smay4finger/WiFiModem/README.md

# WiFiModem
A nice looking Hayes compatible modem fully supporting RS232 on the basis of an ESP8266.

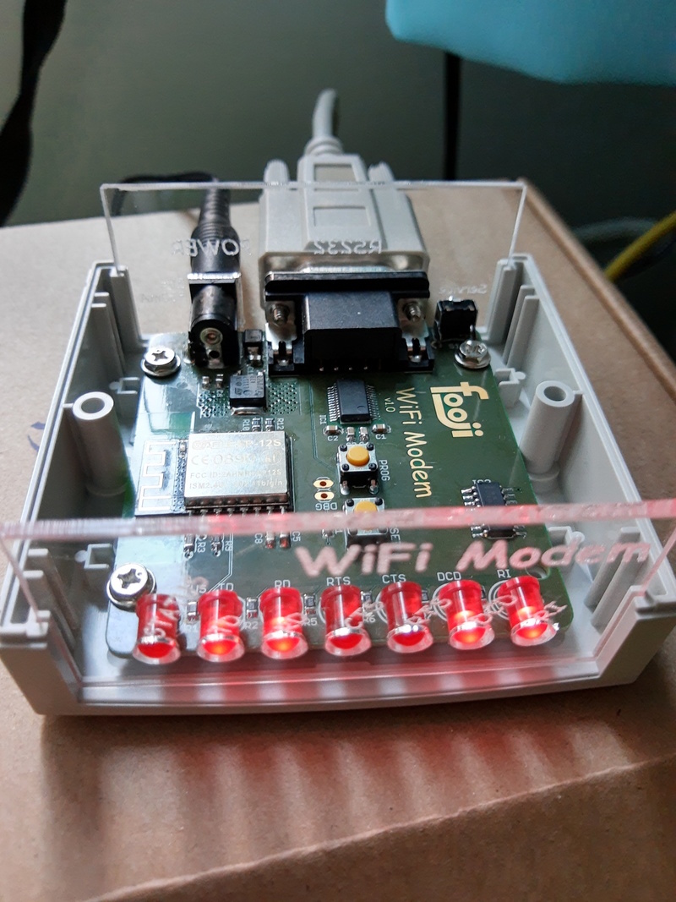
[picture p1: doc/hardware-v1.0.jpg]
Photo of hardware v1.0
