smay4finger/WiFiModem/enclosure/backpanel.dxf

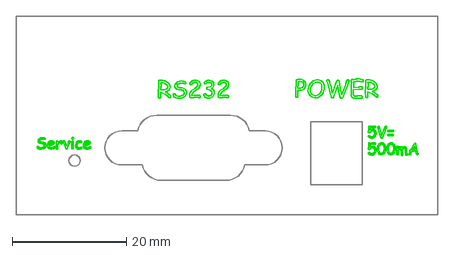
[picture p2: CAD file, 2020-03-23]
enclosure/backpanel.dxf
73.7 x 34.7 mm
