smay4finger/WiFiModem/enclosure/models/bopla-u85-top.stl

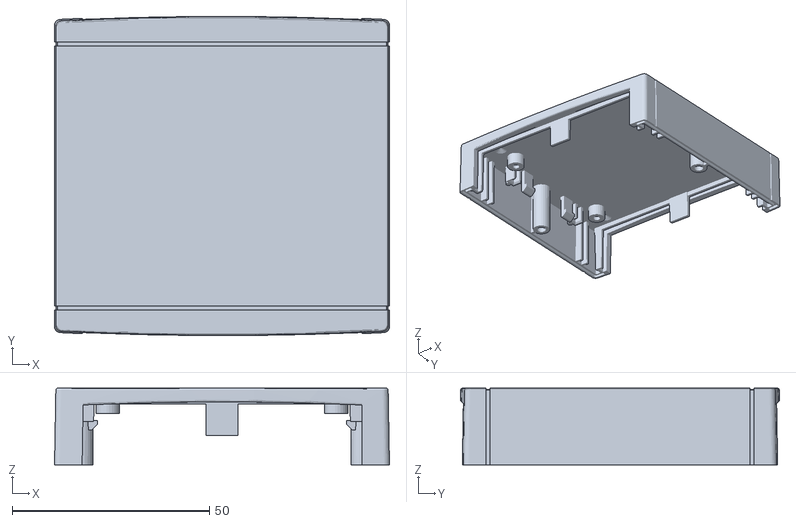
[picture p3: CAD file, 2020-03-23]
enclosure/models/bopla-u85-top.stl
85.0 x 81.0 x 19.5
