smay4finger/WiFiModem/enclosure/frontpanel.dxf

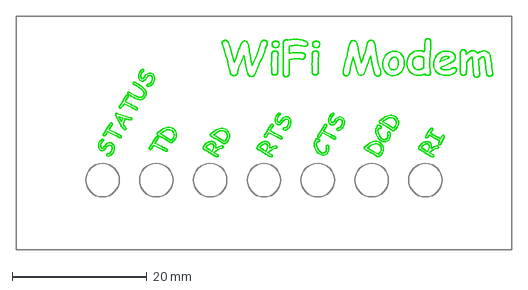
[picture p4: CAD file, 2020-03-23]
enclosure/frontpanel.dxf
73.7 x 34.7 mm
