smay4finger/WiFiModem/enclosure/models/bopla-u85-bot.stl

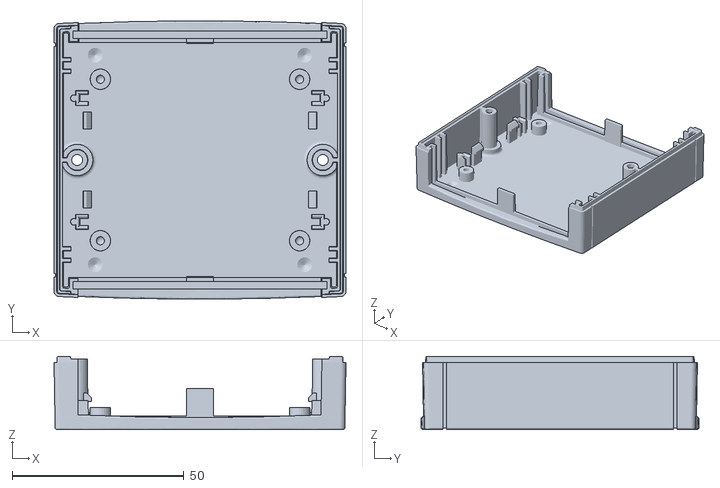
[picture p5: CAD file, 2020-03-23]
enclosure/models/bopla-u85-bot.stl
85.0 x 81.0 x 21.3
