smay4finger/WiFiModem/(threads)

Thread 2 (2021-01-21):

LEDs need to be inverted

smay4finger, 2021-01-21:
LEDs are on when idle on RS232. Would be better to invert, so CTS LED on means actually Clear To Send. A condensator parallel to the LED will help to improve visibility.
