smay4finger/WiFiModem/hardware/modem.brd

## EAGLE design hardware/modem.brd (2020-03-23)

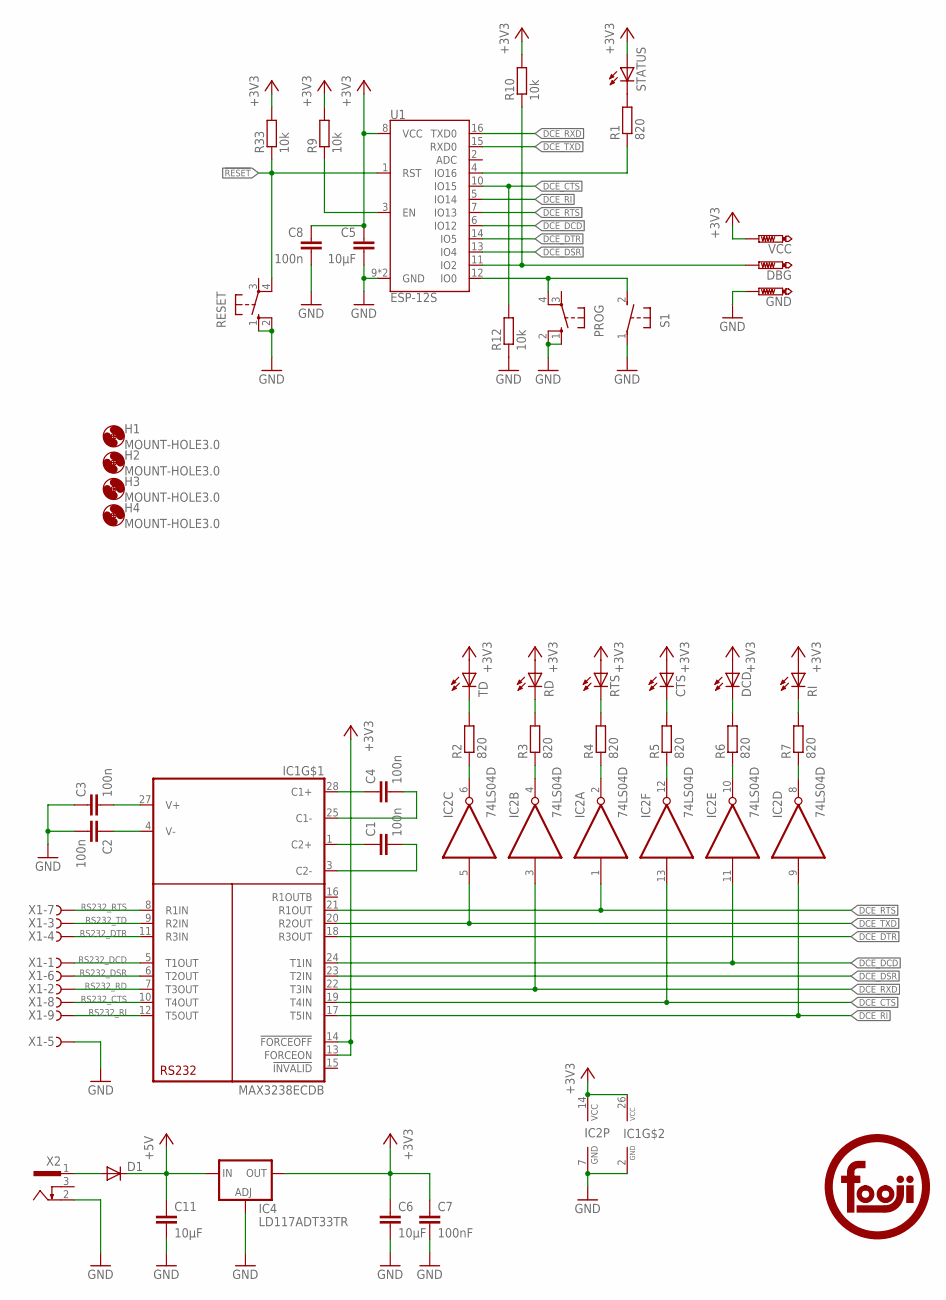
[picture p6: schematic modem.sch]

Parts:
C1, C2, C3, C4, C8: 100n; C0805
C5, C6, C11: 10µF; C0805
C7: 100nF; C0805
CTS: LED5MM
D1: DIODE-SMB; SMB
DBG: PTR1PAD1-13; P1-13
DCD: LED5MM
GND: PTR1PAD1-13; P1-13
H1, H2, H3, H4: MOUNT-HOLE3.0; 3,0
IC1: MAX3238ECDB; SSOP28
IC2: 74LS04D; SO14
IC4: LD117ADT33TR; DPACK
PROG: 10-XX; B3F-10XX
R1, R2, R3, R4, R5, R6, R7: 820; R0805
R9, R10, R12, R33: 10k; R0805
RD: LED5MM
RESET: 10-XX; B3F-10XX
RI: LED5MM
RTS: LED5MM
S1: 31-XX; B3F-31XX
STATUS: LED5MM
TD: LED5MM
U1: ESP-12S
U$3: LOGOTOP_NOCIRCLE_TSTOP; LOGO_TOP_NOCIRCLE_TSTOP
VCC: PTR1PAD1-13; P1-13
X1: F09HPS; F09HP
X2: 733980-62

Connections:
!RESET: R33.1, RESET.4 (P1), U1.1 (RST)
+3V3: C5.1, C6.1, C7.1, C8.1, CTS.A, DCD.A, IC1.13 (FORCEON), IC1.14 (!FORCEOFF), IC1.26 (VCC), IC2.14 (VCC), IC4.4 (OUT), R9.2, R10.2, R33.2, RD.A, RI.A, RTS.A, STATUS.A, TD.A, U1.8 (VCC), VCC.TP
+5V: C11.1, D1.C, IC4.3 (IN)
DCE_CTS: IC1.19 (T4IN), IC2.13 (I), R12.2, U1.10 (IO15)
DCE_DCD: IC1.24 (T1IN), IC2.11 (I), U1.6 (IO12)
DCE_DSR: IC1.23 (T2IN), U1.13 (IO4)
DCE_DTR: IC1.18 (R3OUT), U1.14 (IO5)
DCE_RI: IC1.17 (T5IN), IC2.9 (I), U1.5 (IO14)
DCE_RTS: IC1.21 (R1OUT), IC2.1 (I), U1.7 (IO13)
DCE_RXD: IC1.22 (T3IN), IC2.3 (I), U1.16 (TXD0)
DCE_TXD: IC1.20 (R2OUT), IC2.5 (I), U1.15 (RXD0)
DEBUG: DBG.TP, R10.1, U1.11 (IO2)
GND: C2.2, C3.1, C5.2, C6.2, C7.2, C8.2, C11.2, GND.TP, IC1.2 (GND), IC2.7 (GND), IC4.1 (ADJ), PROG.1 (S), PROG.2 (S1), R12.1, RESET.1 (S), RESET.2 (S1), S1.1, U1.9 (GND), U1.P$1 (GND), X1.5 (F), X2.2
unnamed: R1.2, STATUS.K (C)
unnamed: IC2.6 (O), R2.1
unnamed: R9.1, U1.3 (EN)
unnamed: D1.A, X2.1
unnamed: R2.2, TD.K (C)
unnamed: R3.2, RD.K (C)
unnamed: IC2.4 (O), R3.1
unnamed: IC2.2 (O), R4.1
unnamed: IC2.12 (O), R5.1
unnamed: CTS.K (C), R5.2
unnamed: C2.1, IC1.4 (V-)
unnamed: C3.2, IC1.27 (V+)
unnamed: C1.1, IC1.1 (C2+)
unnamed: C1.2, IC1.3 (C2-)
unnamed: C4.2, IC1.25 (C1-)
unnamed: C4.1, IC1.28 (C1+)
unnamed: DCD.K (C), R6.2
unnamed: R7.2, RI.K (C)
unnamed: IC2.8 (O), R7.1
unnamed: IC2.10 (O), R6.1
unnamed: R4.2, RTS.K (C)
unnamed: PROG.4 (P1), S1.2 (S), U1.12 (IO0)
RS232_CTS: IC1.10 (T4OUT), X1.8 (F)
RS232_DCD: IC1.5 (T1OUT), X1.1 (F)
RS232_DSR: IC1.6 (T2OUT), X1.6 (F)
RS232_DTR: IC1.11 (R3IN), X1.4 (F)
RS232_RD: IC1.7 (T3OUT), X1.2 (F)
RS232_RI: IC1.12 (T5OUT), X1.9 (F)
RS232_RTS: IC1.8 (R1IN), X1.7 (F)
RS232_TD: IC1.9 (R2IN), X1.3 (F)
STATUS_A: R1.1, U1.4 (IO16)

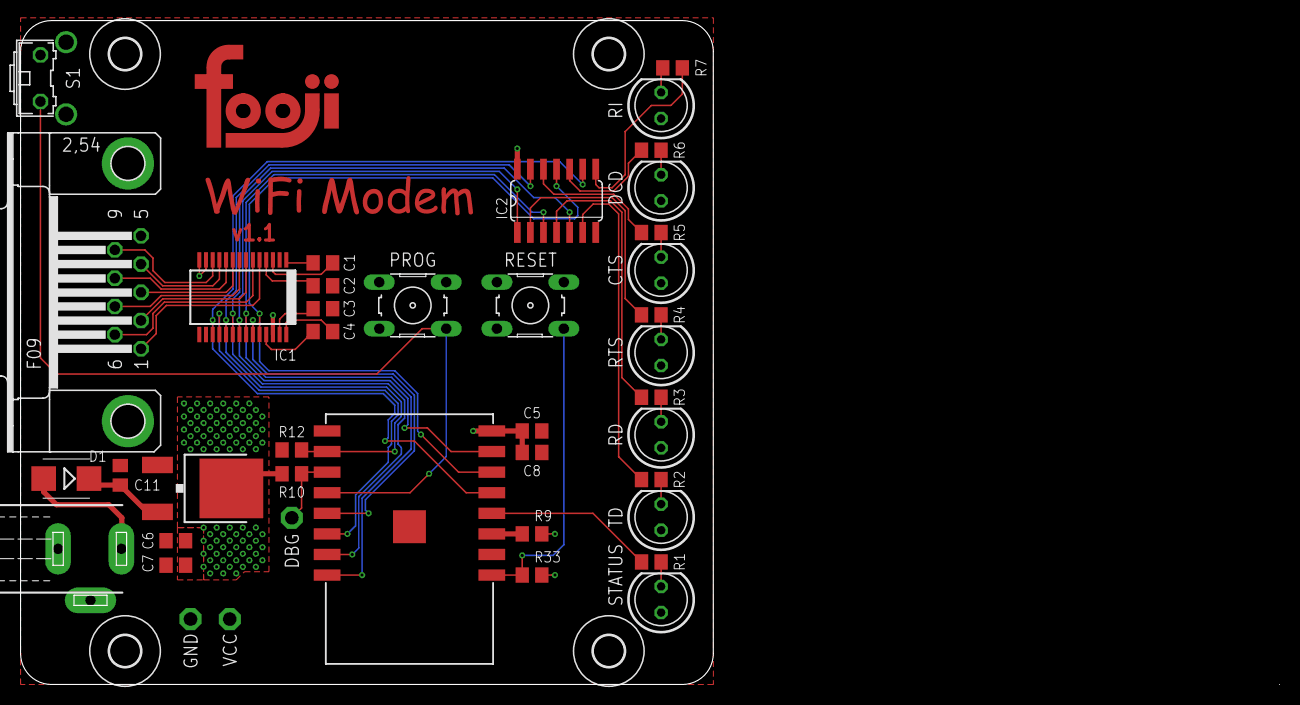
[picture p7: board modem.brd from above]

Board: 2 copper layers, 67.3 x 64.5 mm, 45 parts (0 on the bottom side), 44 nets.
