smay4finger/WiFiModem/(commit log)

2020-03-23 first version of PCB
    [modem.brd, modem.sch]
2020-03-23 fixed lots of minor problems of the first prototype
    - mount holes too large (3.2mm instead of 3.0mm)
    - missing keep-out around mount holes
    - resistor collides with screw in mount hole
    - button S1 collides with screw in mount hole
    - C6 and C7 were hard to solder, thermals on around caps
    - LEDs were hard to solder, thermals on VCC layer
    - debug port position and layout
    - cosmetic changes
    [modem.brd, modem.sch]
2020-03-23 added Makefile for generating gerbers and previews
2020-03-23 added enclosure 3D models
    [backpanel.dxf, bopla-u85-bot.stl, bopla-u85-top.stl, enclosure.scad, frontpanel.dxf]
2021-01-21 Fix broken up sending of escape sequences
    This is a fix for https://github.com/bozimmerman/Zimodem/issues/31
    Zimodem was sending character received on the serial port to the
    socket one by one. As the TCP stack is configured to send out data as
    soon as possible (setNoDelay), if multiple characters would be
    available to read on the serial port, the first one would always be
    sent to the server immediately. As the IP stack always waits for a
    packet sent to be acknowledged by the server before sending the next
    one, this would cause a potentially long time gap between the ESC
    character introducing the escape sequence and the rest of it. Some
    server software would then interpret the ESC charact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
    [zstream.h, zstream.ino]
2021-01-21 formatted code with Arduino IDE
2021-01-21 changed ZIMODEM defines to WIFIMODEM
    This we will do to reflect the huge changes coming. Plan is to remove
    support for ESP32 and also streamline the configuration.
2021-01-21 added factory reset with button
    [firmware.ino]
2021-01-22 use arduino-cli for building
